Mglattfelder/Enlarger-LED-Lightsource/(commit log)

2020-07-29 Add files via upload
    Arduino code
2024-06-25 Delete LED Light controller for enlargers_global_1_0.pdf
    New version 2.0 added
